Snackels/WRO_Future-Engineer_Sunflower/Robot/Vehicle photos/Top_View.jpg

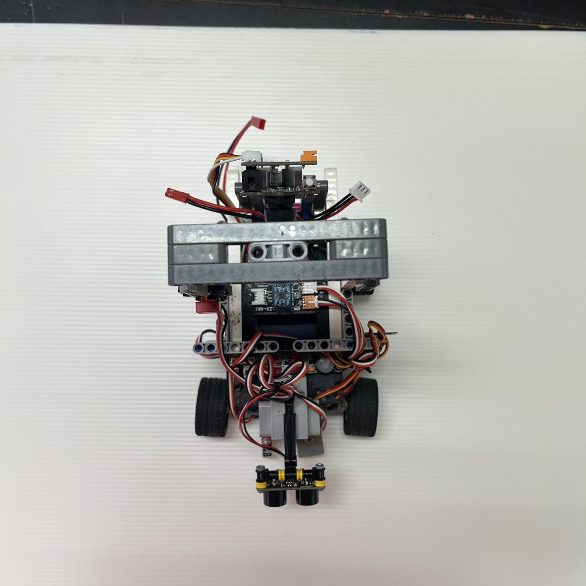
Robot/Vehicle photos/Top_View.jpg
