Snackels/WRO_Future-Engineer_Sunflower/Team_Photos/Silly_Photo.jpg

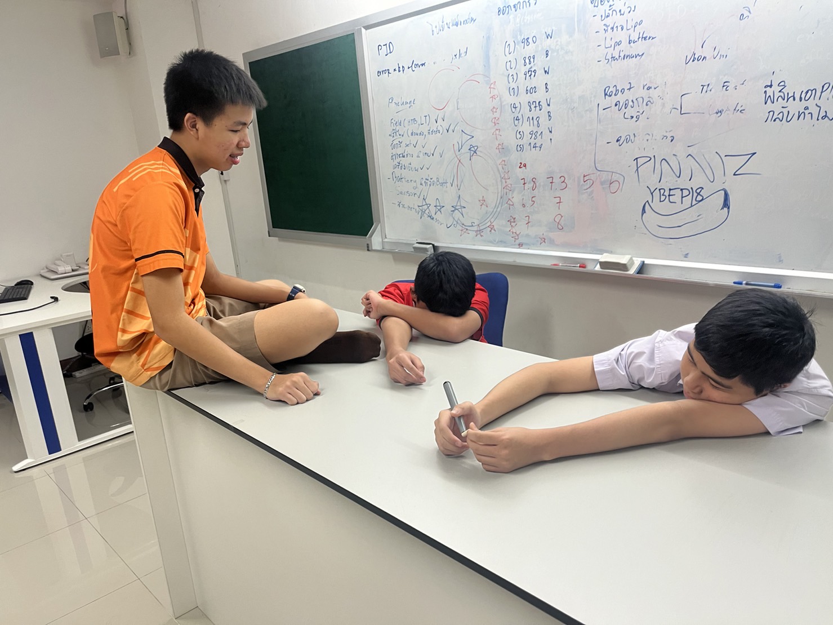
Team_Photos/Silly_Photo.jpg
