Snackels/WRO_Future-Engineer_Sunflower/Robot/Vehicle photos/Back_View.jpg

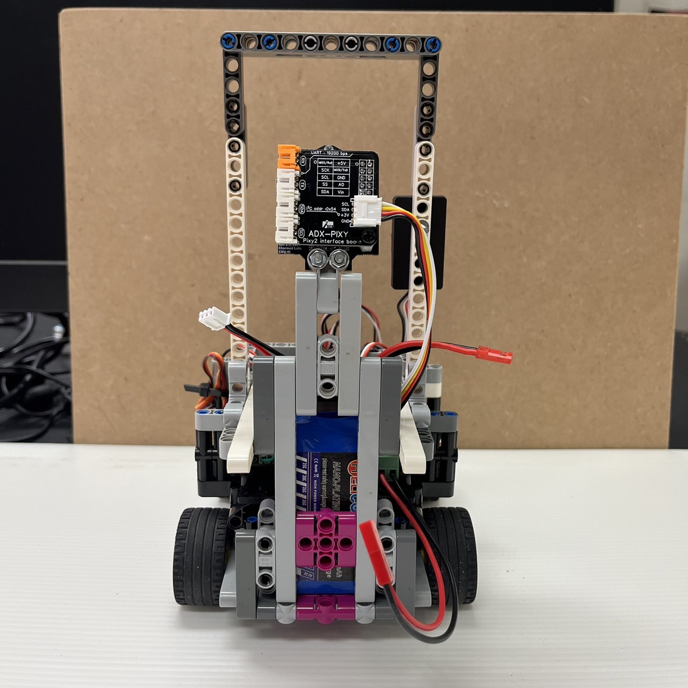
Robot/Vehicle photos/Back_View.jpg
