Snackels/WRO_Future-Engineer_Sunflower/Robot/Vehicle photos/Bottom_View.jpg

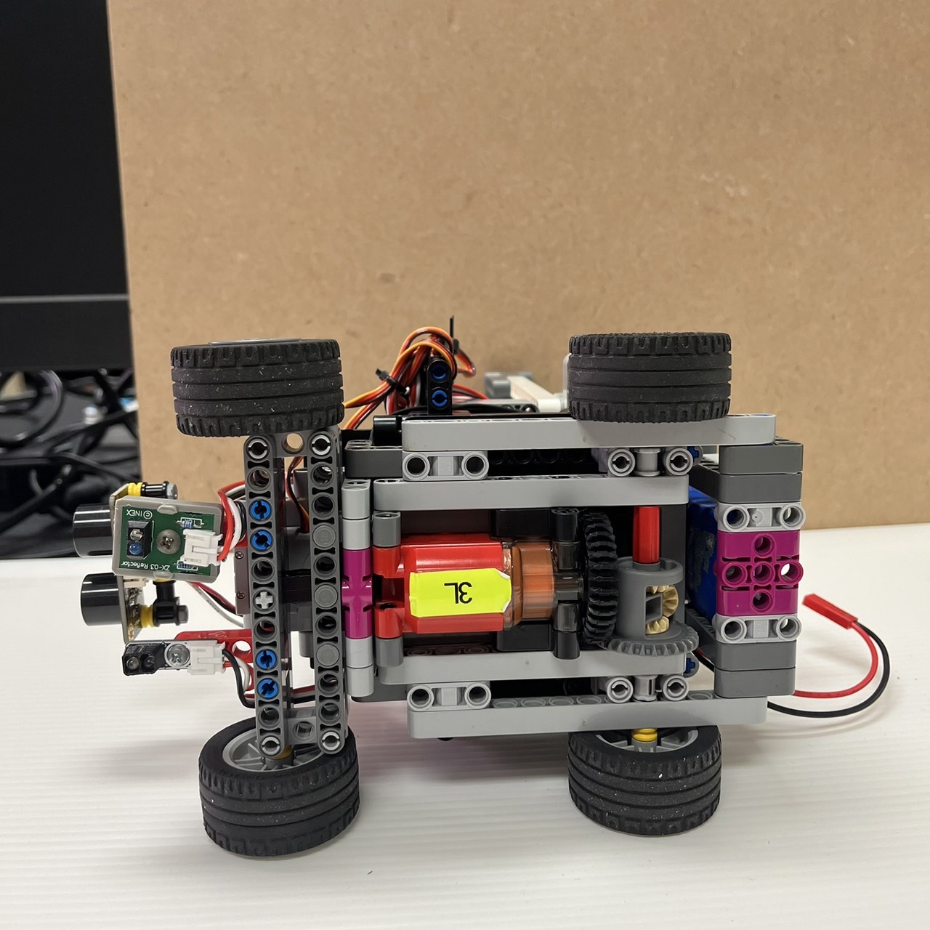
Robot/Vehicle photos/Bottom_View.jpg
