Snackels/WRO_Future-Engineer_Sunflower/Robot/Vehicle photos/Front_View.jpg

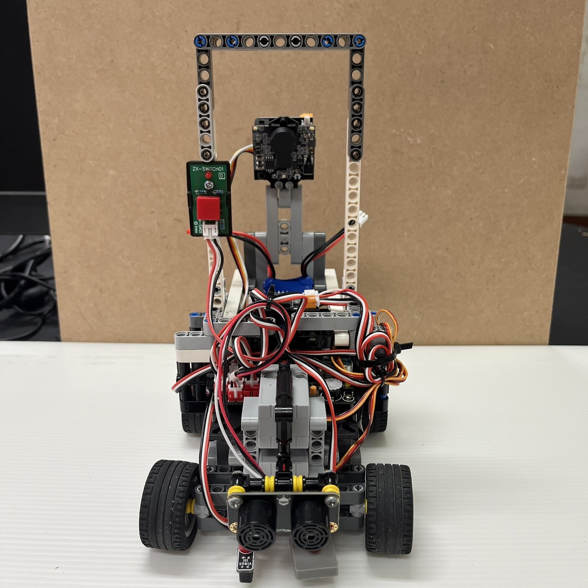
Robot/Vehicle photos/Front_View.jpg
