Snackels/WRO_Future-Engineer_Sunflower/Robot/Vehicle photos/Side_View2.jpg

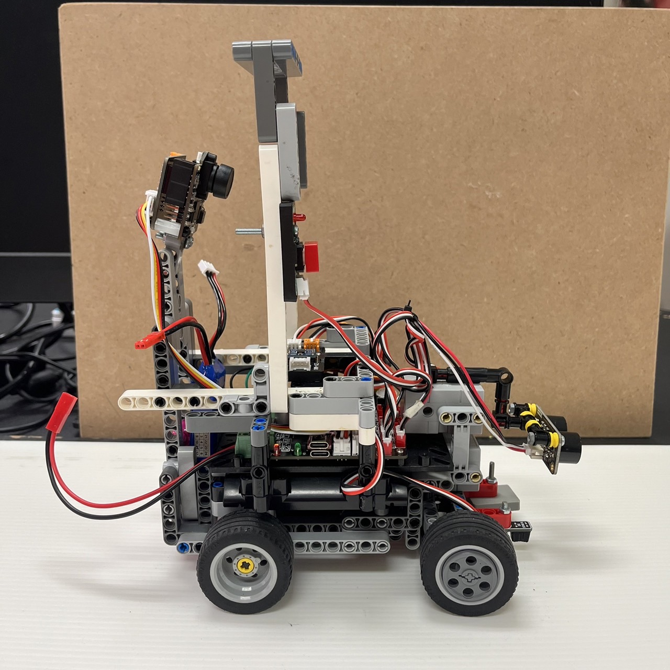
Robot/Vehicle photos/Side_View2.jpg
