Snackels/WRO_Future-Engineer_Sunflower/Robot/Vehicle photos/Side_View.jpg

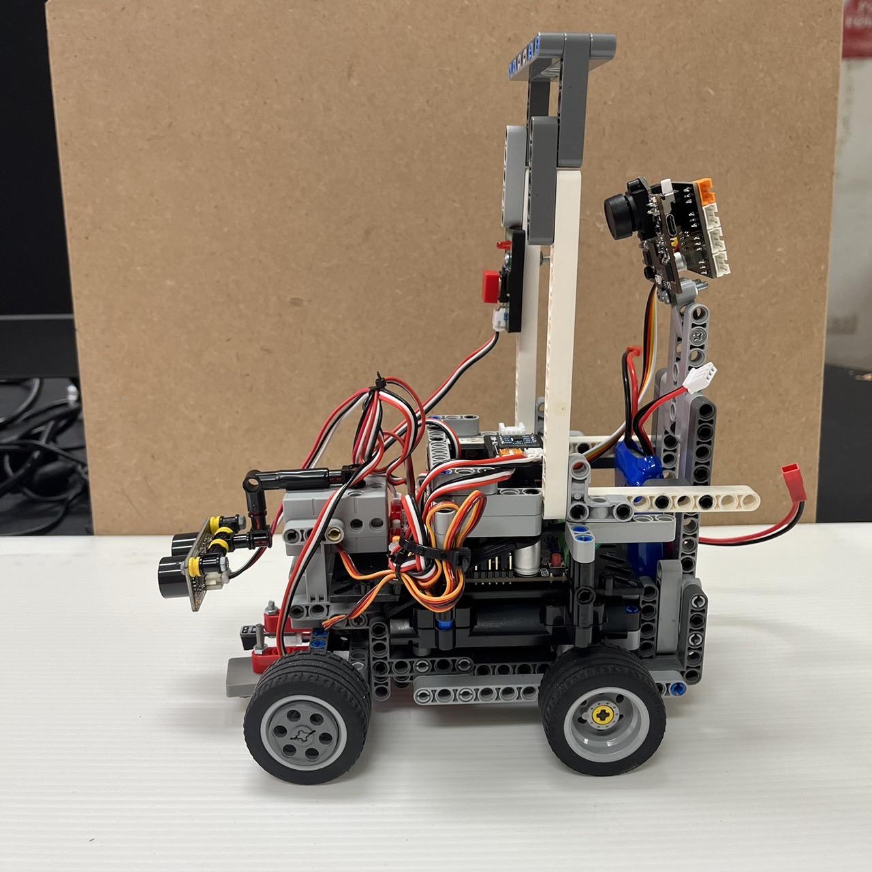
Robot/Vehicle photos/Side_View.jpg
