Snackels/WRO_Future-Engineer_Sunflower/Diagram_and_Electric_Circuit/Diagram.pdf

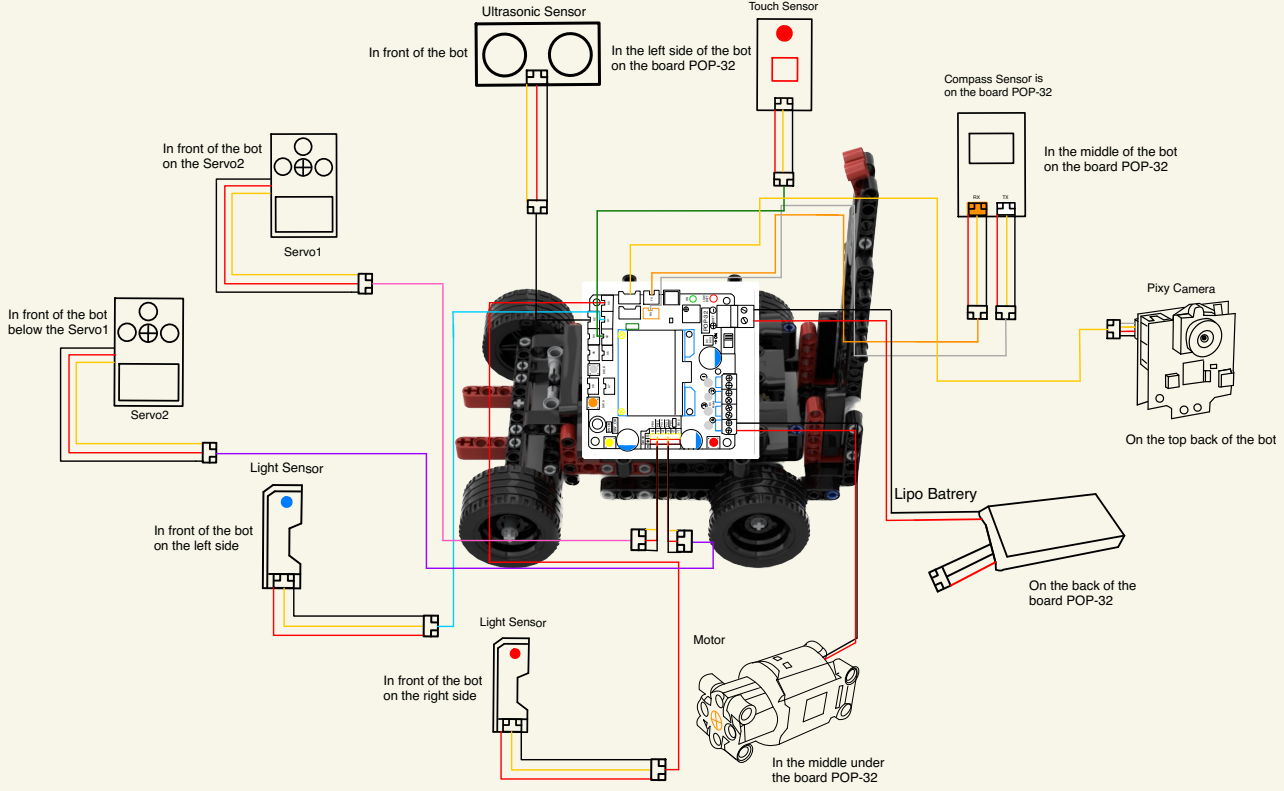
[picture p41: page 1]
Light Sensor; Ultrasonic Sensor; Pixy Camera; Servo1; Servo2; Lipo Batrery; Touch Sensor; Motor; Servo; POP-32; BATT; LOW; A7 KNOB; In front of the bot; In the left side of the bot

on the board POP-32

Compass Sensor is

In front of the bot
on the Servo2

In the middle of the bot

below the Servo1

On the top back of the bot

on the left side

On the back of the
board POP-32

on the right side

In the middle under

the board POP-32
