Snackels/WRO_Future-Engineer_Sunflower/Diagram_and_Electric_Circuit/Electric_Circuit.pdf

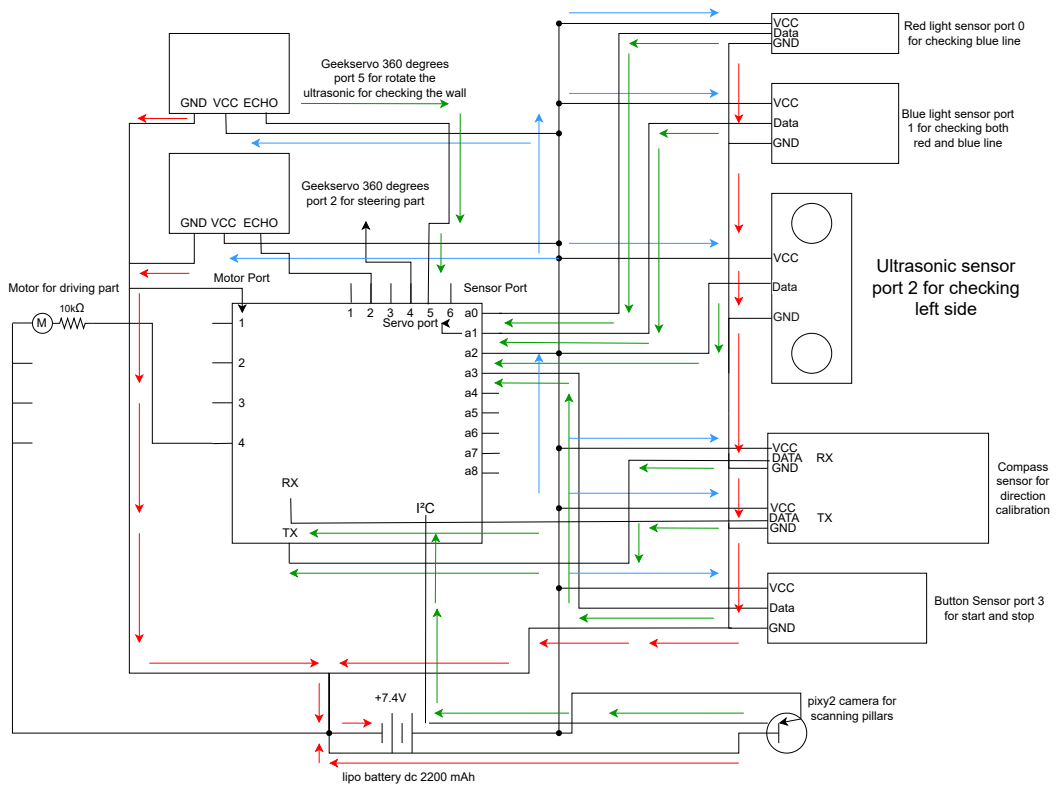
[picture p42: page 1]
VCC; Data; GND; Motor Port; Sensor Port; Compass sensor for direction calibration; VCC DATA GND; Servo port; pixy2 camera for scanning pillars; I²C

Red light sensor port 0
for checking blue line

Geekservo 360 degrees
port 5 for rotate the
ultrasonic for checking the wall

GND VCC ECHO

Blue light sensor port
1 for checking both
red and blue line

port 2 for steering part

Ultrasonic sensor
port 2 for checking
left side

Motor for driving part

Button Sensor port 3
for start and stop

lipo battery dc 2200 mAh
